bkerler/AutoSatTracker-ESP/doc/HS-785HB Servo_files/637118_quarter_scale_servoblock_on_servo_2_600px.jpg

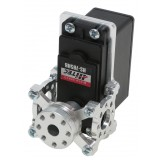
doc/HS-785HB Servo_files/637118_quarter_scale_servoblock_on_servo_2_600px.jpg
