bkerler/AutoSatTracker-ESP/doc/hs-785hb.pdf

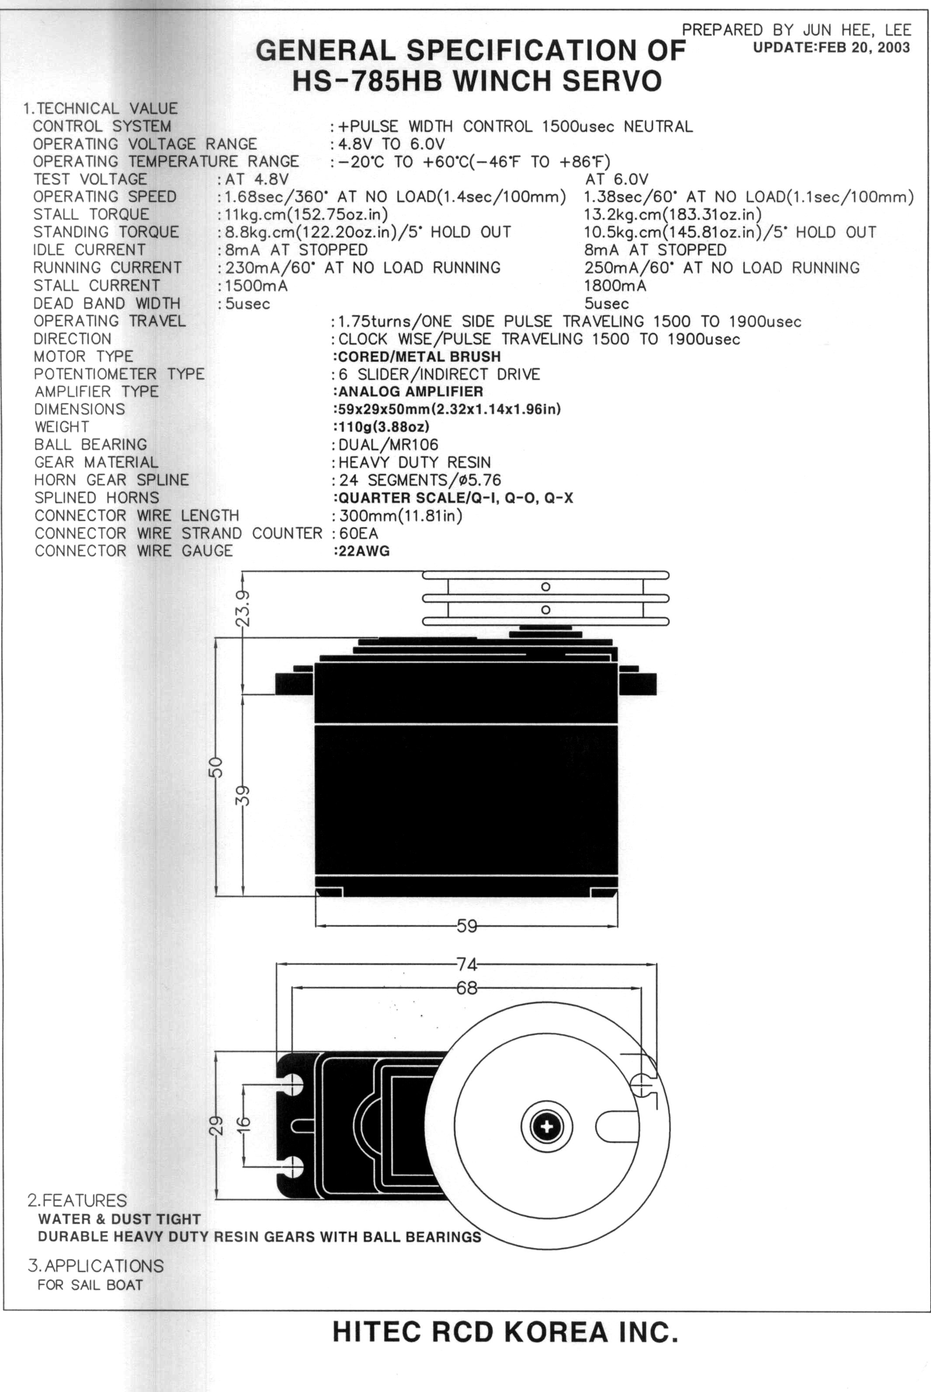
[picture p3: page 1]
