bkerler/AutoSatTracker-ESP/doc/AST-ESP.png

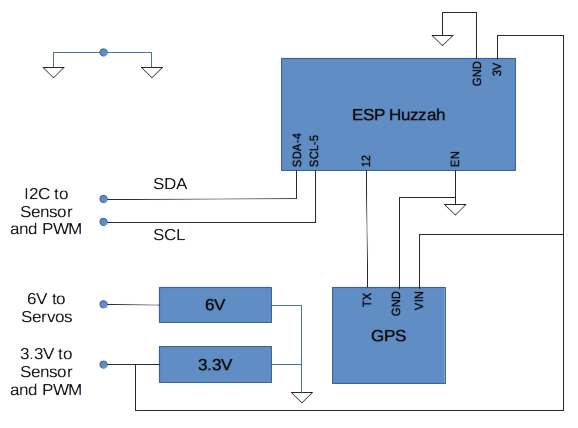
doc/AST-ESP.png
