bkerler/AutoSatTracker-ESP/doc/D645MW Servo_files/32p-hitech-metal-gear-thumbnail.jpg

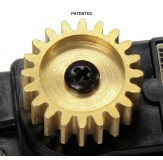
doc/D645MW Servo_files/32p-hitech-metal-gear-thumbnail.jpg
