bkerler/AutoSatTracker-ESP/doc/D645MW Servo_files/32p_futaba_servo_gear_2x2.jpg

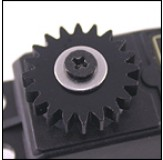
doc/D645MW Servo_files/32p_futaba_servo_gear_2x2.jpg
