bkerler/AutoSatTracker-ESP/doc/D645MW Servo_files/48_pitch_servo_gear_futaba_2x2.jpg

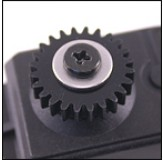
doc/D645MW Servo_files/48_pitch_servo_gear_futaba_2x2.jpg
