bkerler/AutoSatTracker-ESP/doc/D645MW Servo_files/48p_futaba_metal_gear_1.jpg

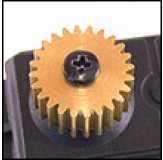
doc/D645MW Servo_files/48p_futaba_metal_gear_1.jpg
