bkerler/AutoSatTracker-ESP/doc/D645MW Servo_files/1804-0032-0001.jpg

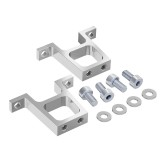
doc/D645MW Servo_files/1804-0032-0001.jpg
