bkerler/AutoSatTracker-ESP/doc/D645MW Servo_files/36645_d645mw_servo_main_600px.jpg

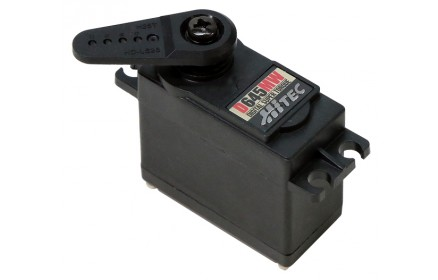
doc/D645MW Servo_files/36645_d645mw_servo_main_600px.jpg
