bkerler/AutoSatTracker-ESP/doc/D645MW Servo_files/44429-dpc-11_dongle-for-pc-programmer-dongle-angle-2-600px.jpg

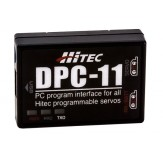
doc/D645MW Servo_files/44429-dpc-11_dongle-for-pc-programmer-dongle-angle-2-600px.jpg
