bkerler/AutoSatTracker-ESP/doc/D645MW Servo_files/55397-1500px.jpg

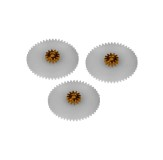
doc/D645MW Servo_files/55397-1500px.jpg
