bkerler/AutoSatTracker-ESP/doc/D645MW Servo_files/55402_hs-625_645_5625_5645_5685_servo_case_set_600px.jpg

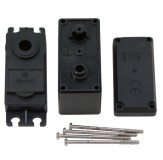
doc/D645MW Servo_files/55402_hs-625_645_5625_5645_5685_servo_case_set_600px.jpg
