bkerler/AutoSatTracker-ESP/doc/D645MW Servo_files/91290a113-1500px.jpg

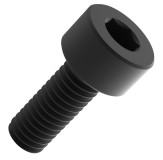
doc/D645MW Servo_files/91290a113-1500px.jpg
