bkerler/AutoSatTracker-ESP/doc/D645MW Servo_files/525124.jpg

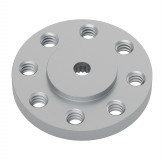
doc/D645MW Servo_files/525124.jpg
