bkerler/AutoSatTracker-ESP/doc/D645MW Servo_files/525130.jpg

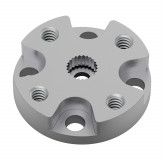
doc/D645MW Servo_files/525130.jpg
