bkerler/AutoSatTracker-ESP/doc/D645MW Servo_files/525136-on-488hb-patented.jpg

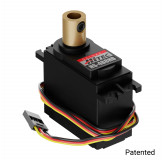
doc/D645MW Servo_files/525136-on-488hb-patented.jpg
