bkerler/AutoSatTracker-ESP/doc/D645MW Servo_files/525142_patented.jpg

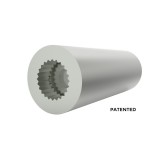
doc/D645MW Servo_files/525142_patented.jpg
