bkerler/AutoSatTracker-ESP/doc/D645MW Servo_files/525144_0280_inch_servo_shaft_spline_end_600px_1_1.jpg

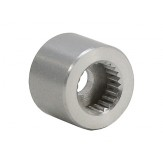
doc/D645MW Servo_files/525144_0280_inch_servo_shaft_spline_end_600px_1_1.jpg
