bkerler/AutoSatTracker-ESP/doc/D645MW Servo_files/575112.jpg

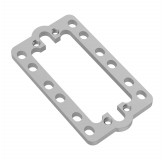
doc/D645MW Servo_files/575112.jpg
