bkerler/AutoSatTracker-ESP/doc/D645MW Servo_files/575124.jpg

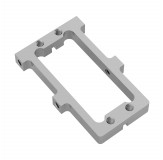
doc/D645MW Servo_files/575124.jpg
