bkerler/AutoSatTracker-ESP/doc/D645MW Servo_files/575144.jpg

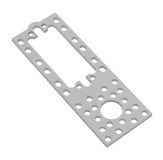
doc/D645MW Servo_files/575144.jpg
