bkerler/AutoSatTracker-ESP/doc/D645MW Servo_files/575148_2.jpg

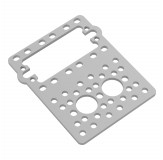
doc/D645MW Servo_files/575148_2.jpg
