bkerler/AutoSatTracker-ESP/doc/D645MW Servo_files/637094_horizontal_gripper_kit_a_main__1.jpg

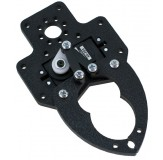
doc/D645MW Servo_files/637094_horizontal_gripper_kit_a_main__1.jpg
