bkerler/AutoSatTracker-ESP/doc/D645MW Servo_files/637096_perpendicular_gripper_kit_b_main_1.jpg

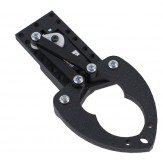
doc/D645MW Servo_files/637096_perpendicular_gripper_kit_b_main_1.jpg
