bkerler/AutoSatTracker-ESP/doc/D645MW Servo_files/637112_standard_futaba_hub_shaft_servoblock_on_servo_2_600px.jpg

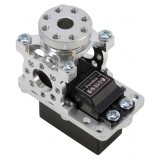
doc/D645MW Servo_files/637112_standard_futaba_hub_shaft_servoblock_on_servo_2_600px.jpg
