bkerler/AutoSatTracker-ESP/doc/D645MW Servo_files/637116_futaba_hitec_servoblock_top_600px.jpg

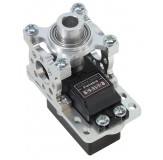
doc/D645MW Servo_files/637116_futaba_hitec_servoblock_top_600px.jpg
