bkerler/AutoSatTracker-ESP/doc/D645MW Servo_files/ddp125_top.jpg

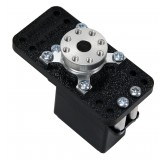
doc/D645MW Servo_files/ddp125_top.jpg
