bkerler/AutoSatTracker-ESP/doc/D645MW Servo_files/ddp155_main.jpg

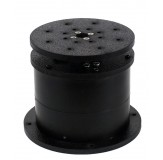
doc/D645MW Servo_files/ddp155_main.jpg
