bkerler/AutoSatTracker-ESP/doc/D645MW Servo_files/ddt500_main.jpg

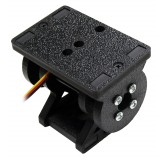
doc/D645MW Servo_files/ddt500_main.jpg
