bkerler/AutoSatTracker-ESP/doc/D645MW Servo_files/ddt540_tilt_system_10_.jpg

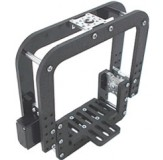
doc/D645MW Servo_files/ddt540_tilt_system_10_.jpg
