bkerler/AutoSatTracker-ESP/doc/D645MW Servo_files/ddt560_tilt_12__1.jpg

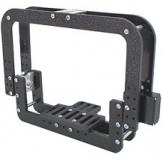
doc/D645MW Servo_files/ddt560_tilt_12__1.jpg
