bkerler/AutoSatTracker-ESP/doc/D645MW Servo_files/hfp-30-digital-servo-programmer-programmer-angled-600px.jpg

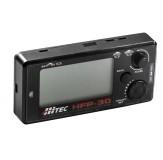
doc/D645MW Servo_files/hfp-30-digital-servo-programmer-programmer-angled-600px.jpg
