bkerler/AutoSatTracker-ESP/doc/D645MW Servo_files/hqdefault_004.jpg

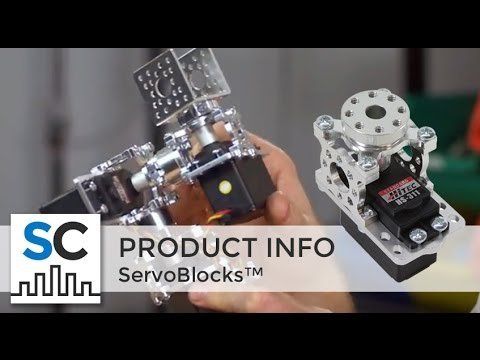
doc/D645MW Servo_files/hqdefault_004.jpg
