bkerler/AutoSatTracker-ESP/doc/D645MW Servo_files/hqdefault_005.jpg

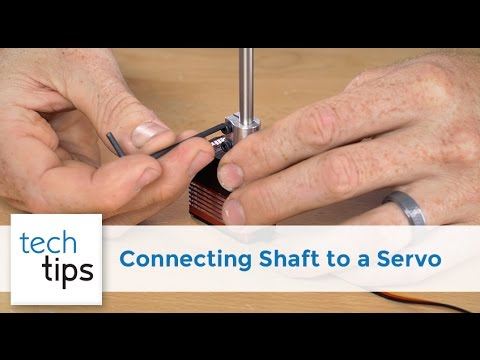
doc/D645MW Servo_files/hqdefault_005.jpg
