bkerler/AutoSatTracker-ESP/doc/D645MW Servo_files/hs25010a-600px.jpg

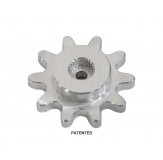
doc/D645MW Servo_files/hs25010a-600px.jpg
