bkerler/AutoSatTracker-ESP/doc/D645MW Servo_files/pn-55395-2-3000px.jpg

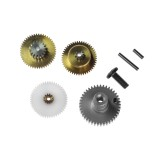
doc/D645MW Servo_files/pn-55395-2-3000px.jpg
