bkerler/AutoSatTracker-ESP/doc/D645MW Servo_files/shaft_1.jpg

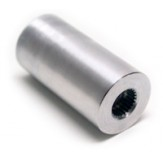
doc/D645MW Servo_files/shaft_1.jpg
