bkerler/AutoSatTracker-ESP/doc/D645MW Servo_files/sprocket-group-pic-1-600px.jpg

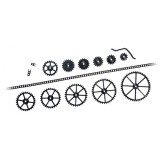
doc/D645MW Servo_files/sprocket-group-pic-1-600px.jpg
