bkerler/AutoSatTracker-ESP/doc/D645MW Servo_files/spt200_main.jpg

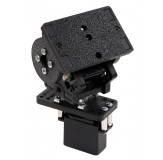
doc/D645MW Servo_files/spt200_main.jpg
