bkerler/AutoSatTracker-ESP/doc/D645MW Servo_files/spt_100_spt100h_main.jpg

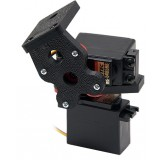
doc/D645MW Servo_files/spt_100_spt100h_main.jpg
