bkerler/AutoSatTracker-ESP/doc/D645MW Servo_files/sr500-servo-rotary-driver-white-bkg-main-600px.jpg

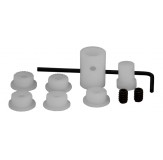
doc/D645MW Servo_files/sr500-servo-rotary-driver-white-bkg-main-600px.jpg
