bkerler/AutoSatTracker-ESP/doc/Downey-AST-Top photo.jpg

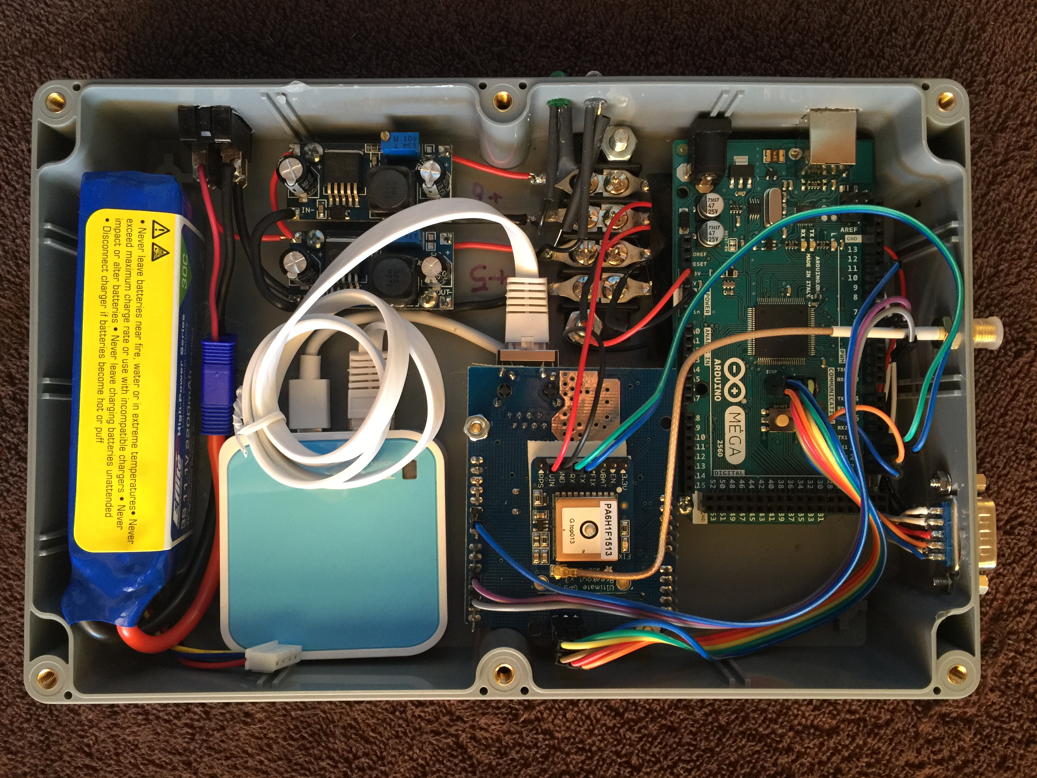
doc/Downey-AST-Top photo.jpg
