bkerler/AutoSatTracker-ESP/doc/HS-785HB Servo_files/48p_hitec_metal_gear_1.jpg

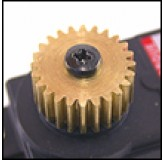
doc/HS-785HB Servo_files/48p_hitec_metal_gear_1.jpg
