bkerler/AutoSatTracker-ESP/doc/HS-785HB Servo_files/55012_hs-785hb_servo_gear_set_1500px.jpg

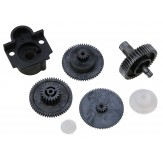
doc/HS-785HB Servo_files/55012_hs-785hb_servo_gear_set_1500px.jpg
