bkerler/AutoSatTracker-ESP/doc/HS-785HB Servo_files/56314_Schematic.jpg

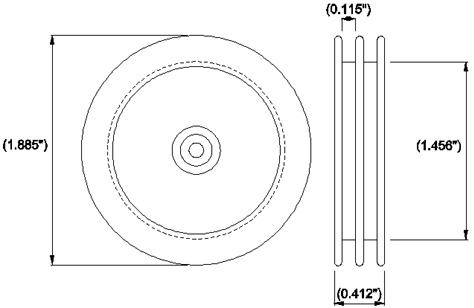
doc/HS-785HB Servo_files/56314_Schematic.jpg
