bkerler/AutoSatTracker-ESP/doc/HS-785HB Servo_files/525116-single-servo-arm-corner-to-corner-top-600px.jpg

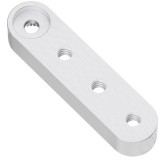
doc/HS-785HB Servo_files/525116-single-servo-arm-corner-to-corner-top-600px.jpg
