bkerler/AutoSatTracker-ESP/doc/HS-785HB Servo_files/525118-dual-servo-arm-corner-to-corner-top-600px.jpg

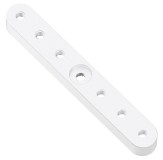
doc/HS-785HB Servo_files/525118-dual-servo-arm-corner-to-corner-top-600px.jpg
