bkerler/AutoSatTracker-ESP/doc/HS-785HB Servo_files/575116.jpg

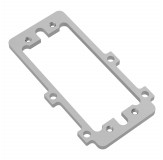
doc/HS-785HB Servo_files/575116.jpg
