bkerler/AutoSatTracker-ESP/doc/HS-785HB Servo_files/637120_quarter_scale_servoblock_on_servo_with_shaft_600px.jpg

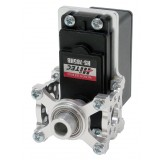
doc/HS-785HB Servo_files/637120_quarter_scale_servoblock_on_servo_with_shaft_600px.jpg
