bkerler/AutoSatTracker-ESP/doc/HS-785HB Servo_files/637169_785_gear_rack_single_sideways_kit_main_600px.jpg

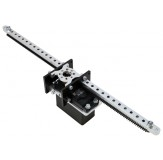
doc/HS-785HB Servo_files/637169_785_gear_rack_single_sideways_kit_main_600px.jpg
