bkerler/AutoSatTracker-ESP/doc/HS-785HB Servo_files/637170_785_gear_rack_kit_angle_600px.jpg

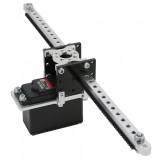
doc/HS-785HB Servo_files/637170_785_gear_rack_kit_angle_600px.jpg
