bkerler/AutoSatTracker-ESP/doc/HS-785HB Servo_files/637171_785_gear_rack_standard_dual_kit_main_600px.jpg

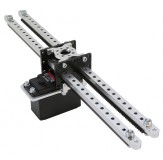
doc/HS-785HB Servo_files/637171_785_gear_rack_standard_dual_kit_main_600px.jpg
