bkerler/AutoSatTracker-ESP/doc/HS-785HB Servo_files/637190_785_gear_rack_sideways_dual_kit_main_600px.jpg

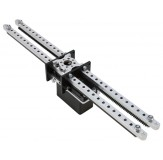
doc/HS-785HB Servo_files/637190_785_gear_rack_sideways_dual_kit_main_600px.jpg
