bkerler/AutoSatTracker-ESP/doc/HS-785HB Servo_files/15435564483DC63035-E2B1-4D74-B549-9035334CB773.jpeg

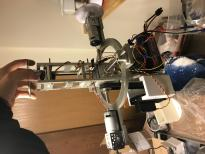
doc/HS-785HB Servo_files/15435564483DC63035-E2B1-4D74-B549-9035334CB773.jpeg
