bkerler/AutoSatTracker-ESP/doc/HS-785HB Servo_files/hs785_slider_kit_back_600px.jpg

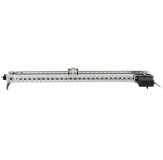
doc/HS-785HB Servo_files/hs785_slider_kit_back_600px.jpg
