bkerler/AutoSatTracker-ESP/doc/HS-785HB Servo_files/hs-785hb_33785s_main.jpg

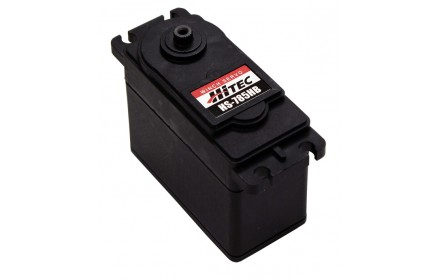
doc/HS-785HB Servo_files/hs-785hb_33785s_main.jpg
