bkerler/AutoSatTracker-ESP/doc/HS-785HB Servo_files/pt-785ss_main_picture.jpg

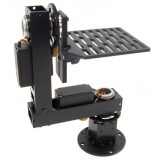
doc/HS-785HB Servo_files/pt-785ss_main_picture.jpg
