bkerler/AutoSatTracker-ESP/doc/HS-785HB Servo_files/rsa32-2hs-12-mounted-on-785hb-cu-3000px.jpg

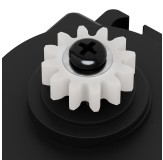
doc/HS-785HB Servo_files/rsa32-2hs-12-mounted-on-785hb-cu-3000px.jpg
