bkerler/AutoSatTracker-ESP/doc/HS-785HB Servo_files/rsa48-2hs-18-mounted-on-785hb-cu-3000px.jpg

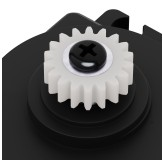
doc/HS-785HB Servo_files/rsa48-2hs-18-mounted-on-785hb-cu-3000px.jpg
