bkerler/AutoSatTracker-ESP/doc/HS-785HB Servo_files/sw1875h_servo_wheel.jpg

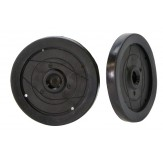
doc/HS-785HB Servo_files/sw1875h_servo_wheel.jpg
