bkerler/AutoSatTracker-ESP/doc/IMG_0182.JPG

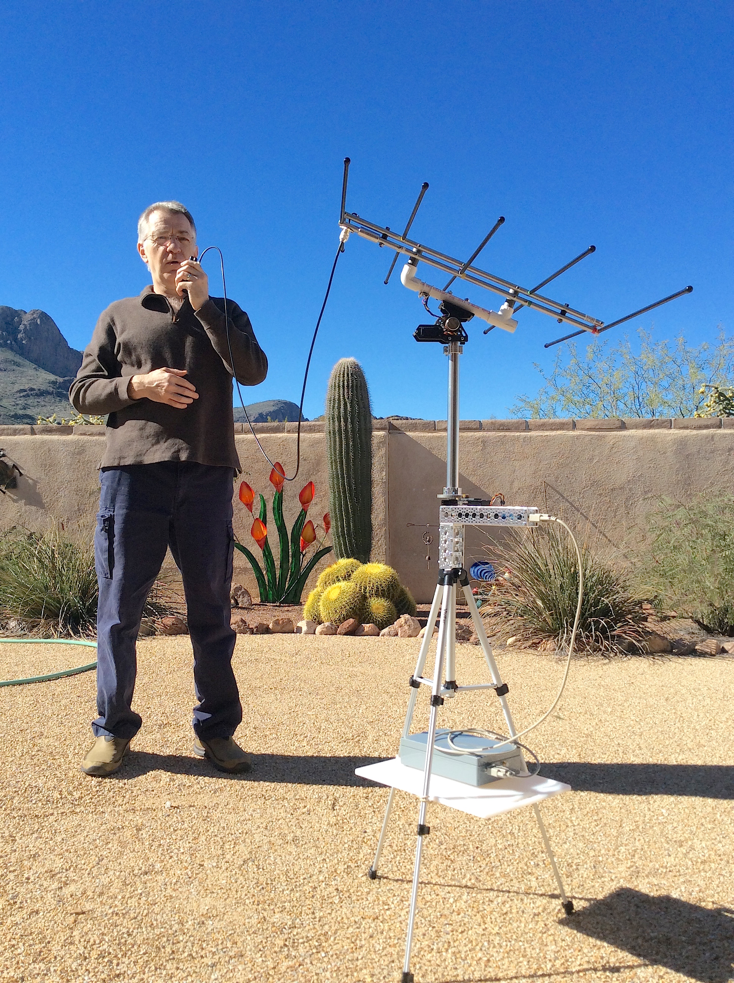
doc/IMG_0182.JPG
