bkerler/AutoSatTracker-ESP/doc/IMG_0186.JPG

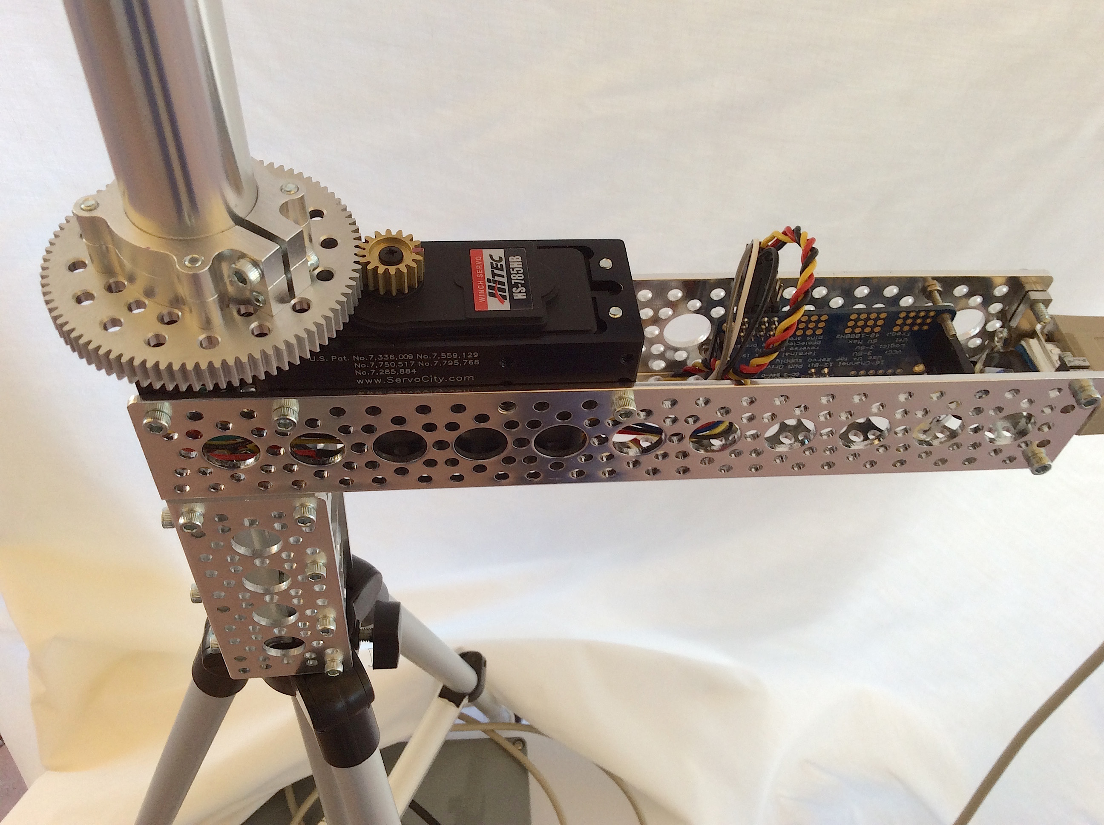
doc/IMG_0186.JPG
