bkerler/AutoSatTracker-ESP/doc/IMG_0195.JPG

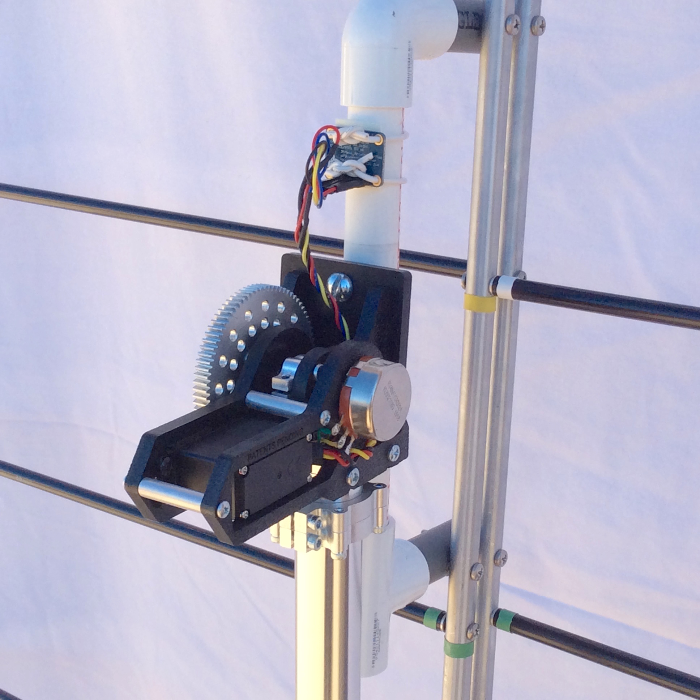
doc/IMG_0195.JPG
