bkerler/AutoSatTracker-ESP/doc/IMG_0196.JPG

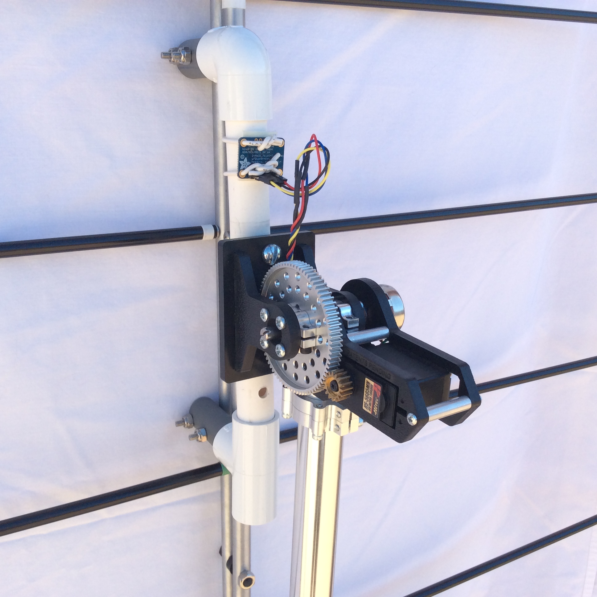
doc/IMG_0196.JPG
