bkerler/AutoSatTracker-ESP/doc/IMG_0198.JPG

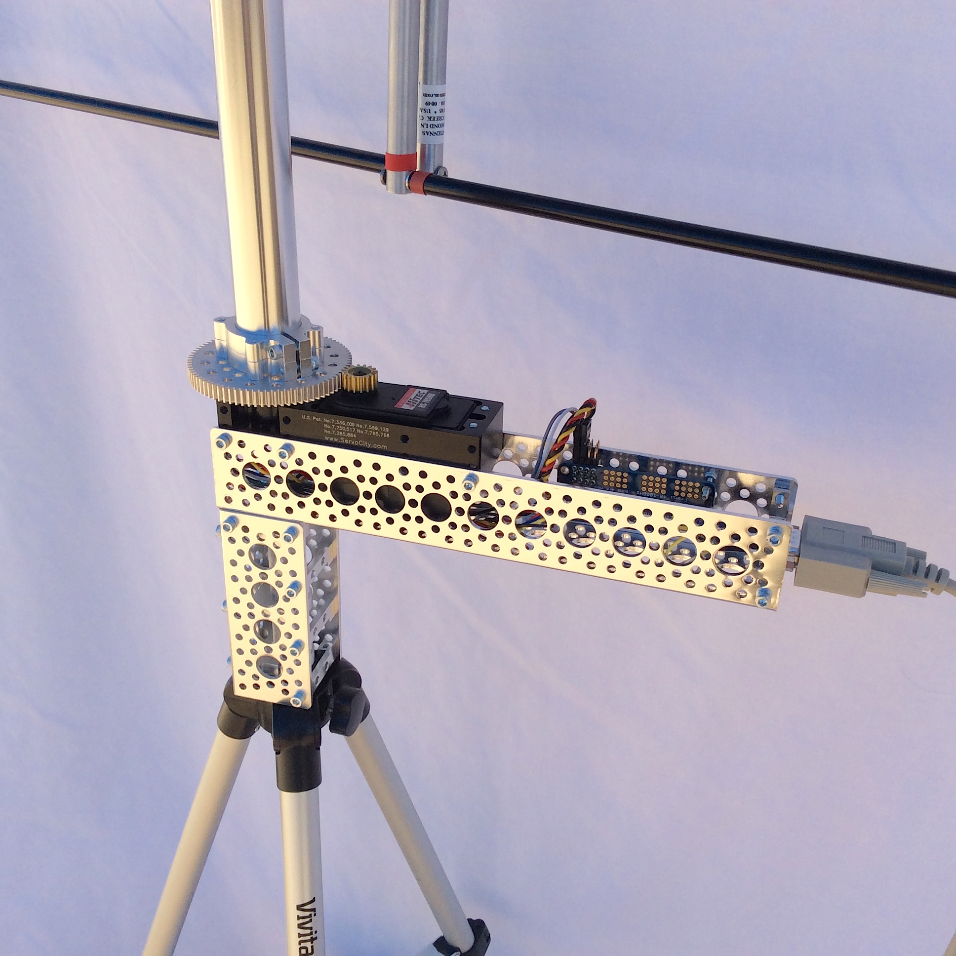
doc/IMG_0198.JPG
