bkerler/AutoSatTracker-ESP/doc/PLAN-13 Satellite Position Calculation Program_files/fig01.gif

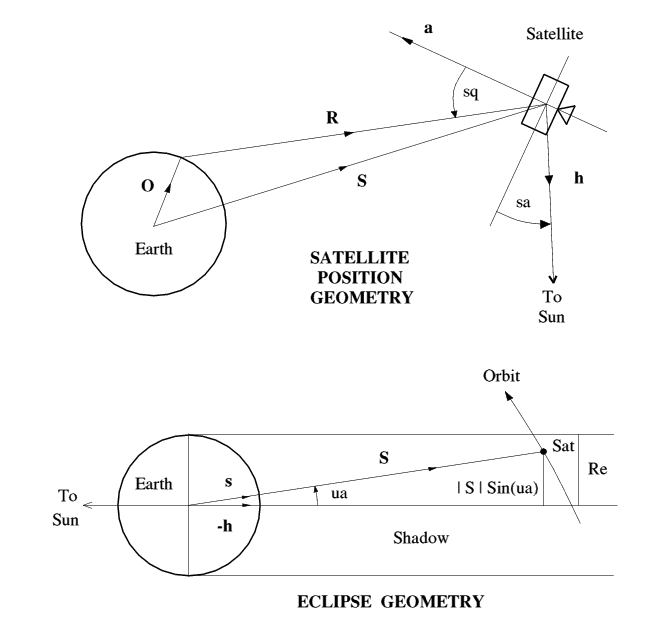
doc/PLAN-13 Satellite Position Calculation Program_files/fig01.gif
