bkerler/AutoSatTracker-ESP/doc/PLAN-13 Satellite Position Calculation Program_files/fig02.gif

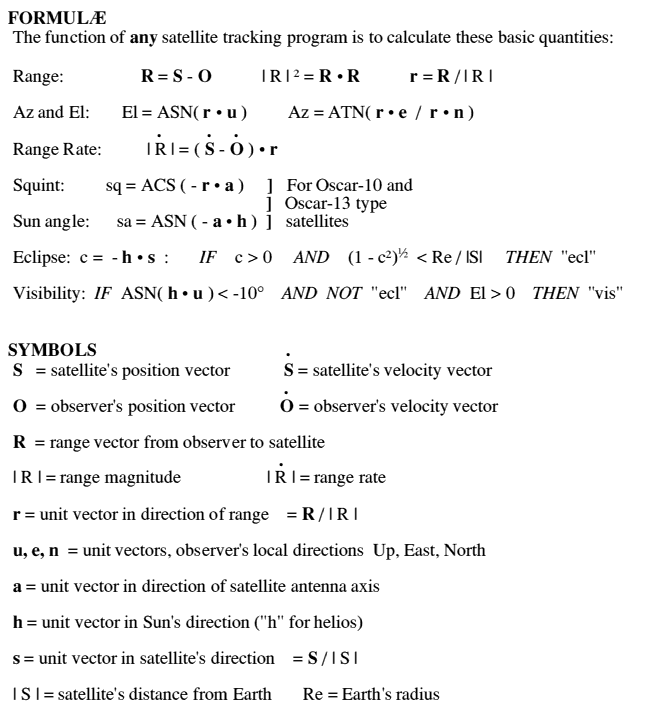
doc/PLAN-13 Satellite Position Calculation Program_files/fig02.gif
