bkerler/AutoSatTracker-ESP/doc/Tripod-closeup.jpg

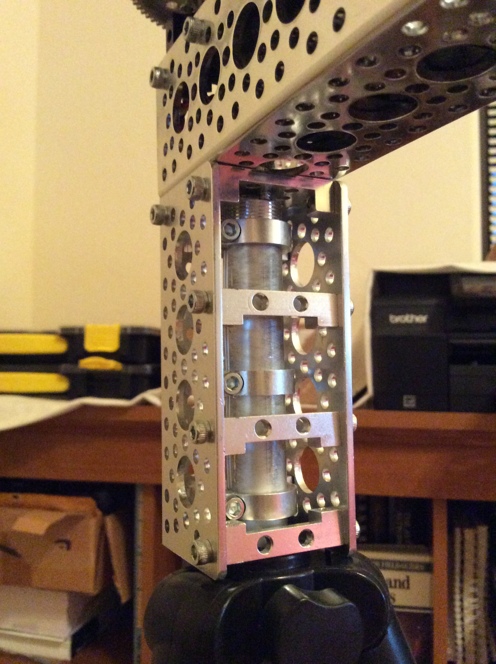
doc/Tripod-closeup.jpg
