bkerler/AutoSatTracker-ESP/doc/Using Arduino IDE | Adafruit Feather HUZZAH ESP8266 | Adafruit Learning System_files/2821-05.jpg

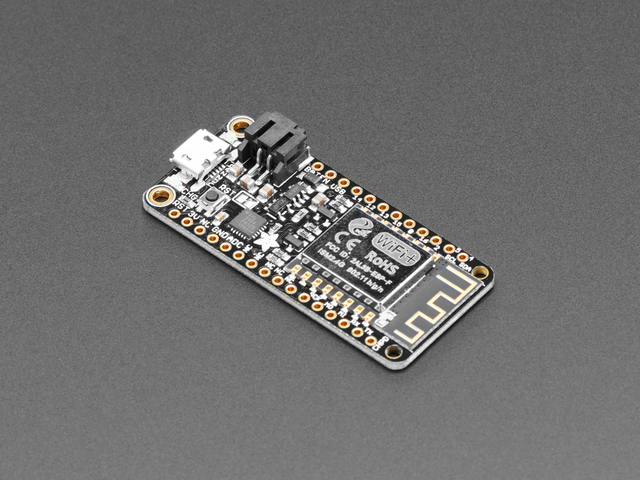
doc/Using Arduino IDE | Adafruit Feather HUZZAH ESP8266 | Adafruit Learning System_files/2821-05.jpg
