bkerler/AutoSatTracker-ESP/doc/D645MW Servo_files/fsa250-assembly-main-1500px.jpg

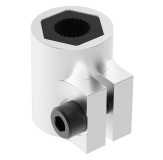
doc/D645MW Servo_files/fsa250-assembly-main-1500px.jpg
