bkerler/AutoSatTracker-ESP/doc/HS-785HB Servo_files/hsa250-assembly-main-1500px.jpg

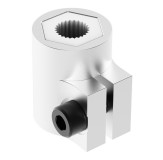
doc/HS-785HB Servo_files/hsa250-assembly-main-1500px.jpg
