bkerler/AutoSatTracker-ESP/(threads)

Thread 3 (2025-06-07):

Constant back and forth movement while tracking.

SamuelHiatt79, 2025-06-07:
On your Github page it says "If the servo moves back and forth on tracking due to measurement errors of the BNO055 sensor, make sure to mod GOOD_ERROR to the error degree (currently 0.8 degree) in Gimbal.h"

There is no GOOD_ERROR in the Gimbal.h script, or any other script in this sketch.

How do you stop the constant back and forth?

bkerler, 2025-06-08:
Actually, GOOD_ERROR is in Gimbal.h, see https://github.com/bkerler/AutoSatTracker-ESP/blob/master/src/Gimbal.h#L26

SamuelHiatt79, 2025-06-12:
I am using your files now. Now I am getting compile errors.
Are you using the Adafruit Feather ESP8266 Huzzah?

SamuelHiatt79, 2025-06-14:
When I complied and uploaded your version. The GPS, Gimbal, and IMU are not detected by the Huzzah.

Any thoughts?
