bkerler/AutoSatTracker-ESP/doc/Downey-AST-Block diagram.pdf

## Autonomous Satellite Tracker

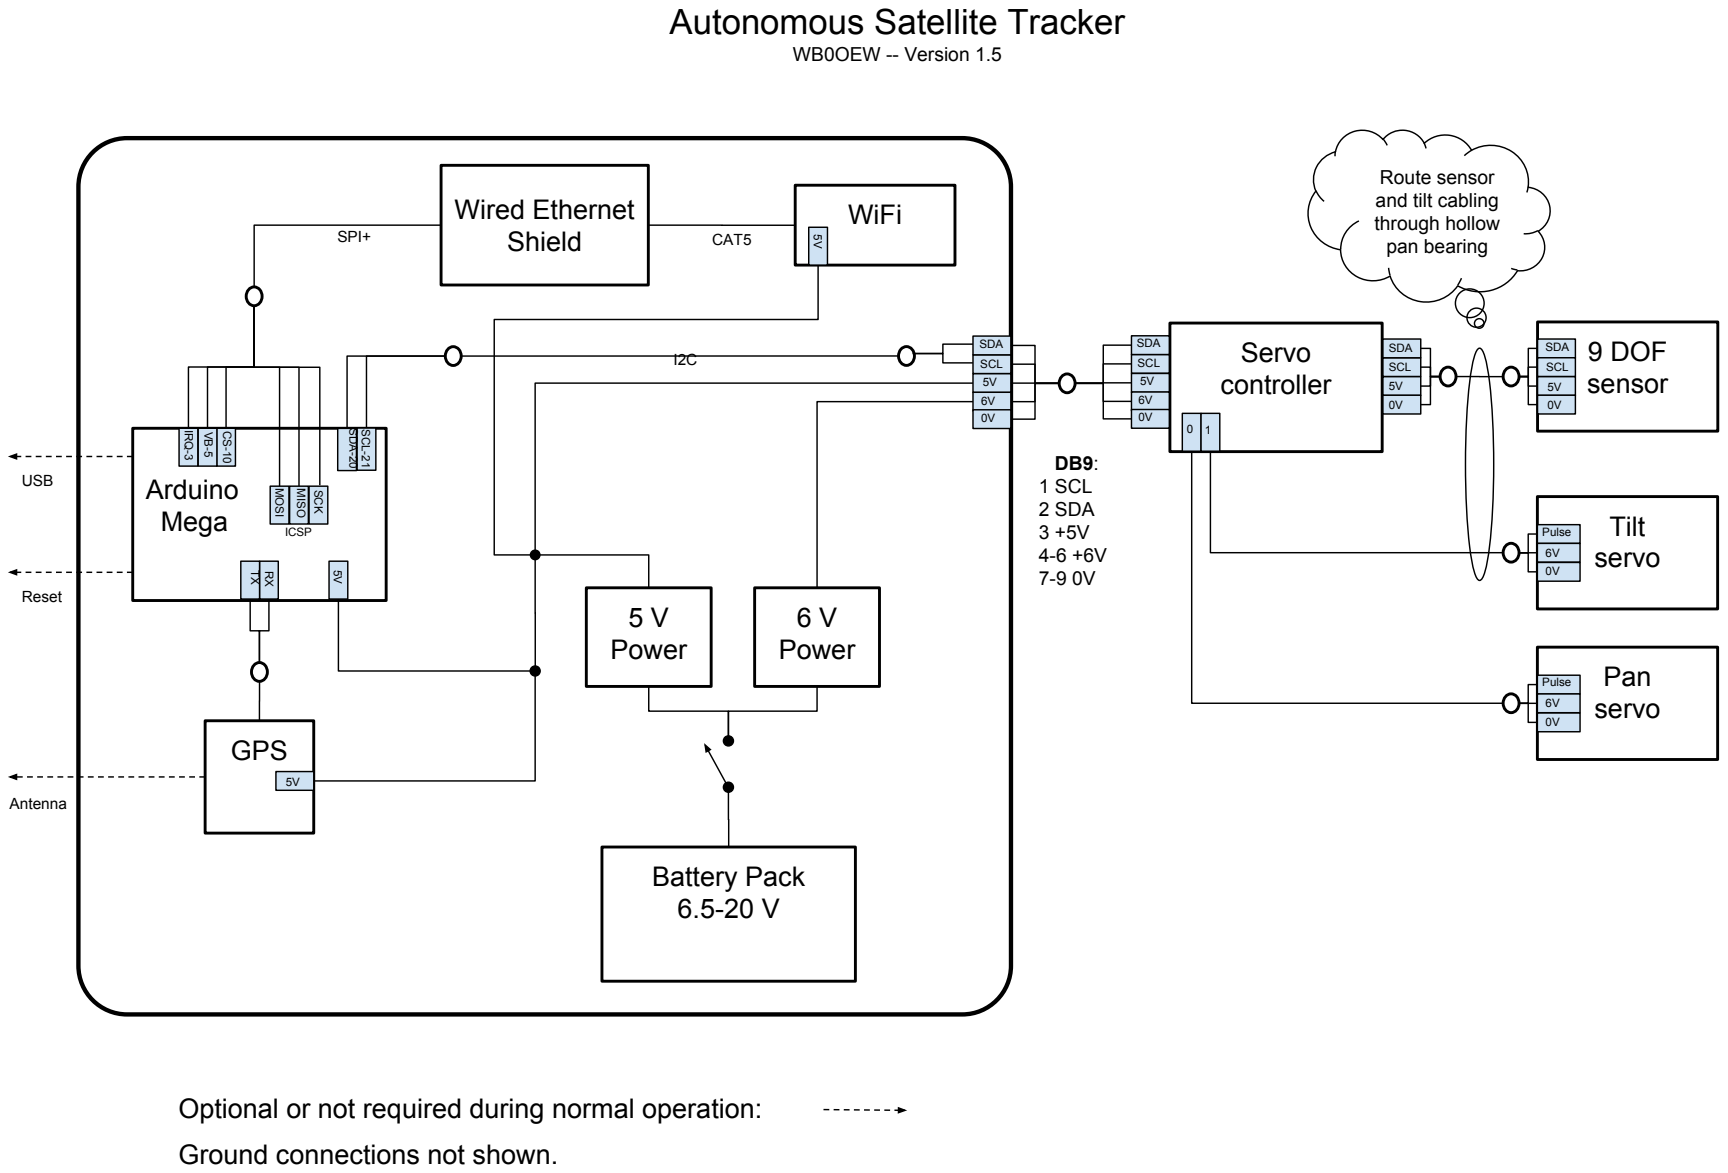
[picture p118: page 1]
Arduino Mega; SDA-20; SCL-21; MISO; IRQ-3; SCK; MOSI; ICSP; Wired Ethernet Shield; WiFi; 6 V Power; Battery Pack 6.5-20 V; WB0OEW -- Version 1.5; Servo controller; CAT5; SPI+; 5 V Power; USB; GPS; Antenna; SDA; SCL; 9 DOF; sensor; Tilt servo ⁶V; Pulse; Pan servo ⁶V; DB9: 1 SCL 2 SDA 3 +5V 4-6 +6V 7-9 0V; Reset

Route sensor
and tilt cabling
through hollow
pan bearing

Optional or not required during normal operation:
Ground connections not shown.
