bkerler/AutoSatTracker-ESP/src/wmm.h

static double epoc = 2025.0;
const double c0[13][13]={
{	0.0,	-29351.8,	-2556.6,	1361.0,	895.0,	-233.2,	64.4,	79.5,	23.2,	4.6,	-1.3,	2.9,	-2.0,	},
{	4545.4,	-1410.8,	2951.1,	-2404.1,	799.5,	368.9,	63.8,	-77.0,	10.8,	7.8,	-6.4,	-1.5,	-0.2,	},
{	-3133.6,	-815.1,	1649.3,	1243.8,	55.7,	187.2,	76.9,	-8.8,	-17.5,	3.0,	0.2,	-2.5,	0.3,	},
{	-56.6,	237.5,	-549.5,	453.6,	-281.1,	-138.7,	-115.7,	59.3,	2.0,	-0.2,	2.0,	2.4,	1.2,	},
{	278.6,	-133.9,	212.0,	-375.6,	12.1,	-142.0,	-40.9,	15.8,	-21.7,	-2.5,	-1.0,	-0.6,	-1.3,	},
{	45.4,	220.2,	-122.9,	43.0,	106.1,	20.9,	14.9,	2.5,	16.9,	-13.1,	-0.6,	-0.1,	0.6,	},
{	-18.4,	16.8,	48.8,	-59.8,	10.9,	72.7,	-60.7,	-11.1,	15.0,	2.4,	-0.9,	-0.6,	0.6,	},
{	-48.9,	-14.4,	-1.0,	23.4,	-7.4,	-25.1,	-2.3,	14.2,	-16.8,	8.6,	1.5,	-0.1,	0.5,	},
{	7.1,	-12.6,	11.4,	-9.7,	12.7,	0.7,	-5.2,	3.9,	0.9,	-8.7,	0.9,	1.1,	-0.1,	},
{	-24.8,	12.2,	8.3,	-3.3,	-5.2,	7.2,	-0.6,	0.8,	10.0,	-12.9,	-2.7,	-1.0,	-0.4,	},
{	3.3,	0.0,	2.4,	5.3,	-9.1,	0.4,	-4.2,	-3.8,	0.9,	-9.1,	-3.9,	-0.2,	-0.2,	},
{	0.0,	2.9,	-0.6,	0.2,	0.5,	-0.3,	-1.2,	-1.7,	-2.9,	-1.8,	-2.3,	2.6,	-1.3,	},
{	-1.3,	0.7,	1.0,	-1.4,	-0.0,	0.6,	-0.1,	0.8,	0.1,	-1.0,	0.1,	0.2,	-0.7,	},
};
const double cd0[13][13]={
{	0.0,	12.0,	-11.6,	-1.3,	-1.6,	0.6,	-0.2,	-0.0,	-0.1,	-0.0,	0.1,	0.0,	0.0,	},
{	-21.5,	9.7,	-5.2,	-4.2,	-2.4,	1.4,	-0.4,	-0.1,	0.2,	-0.1,	0.0,	-0.0,	0.0,	},
{	-27.7,	-12.1,	-8.0,	0.4,	-6.0,	0.0,	0.9,	-0.1,	0.0,	0.1,	0.1,	0.0,	-0.0,	},
{	4.0,	-0.3,	-4.1,	-15.6,	5.6,	0.6,	1.2,	0.5,	0.5,	0.3,	0.1,	0.0,	-0.0,	},
{	-1.1,	4.1,	1.6,	-4.4,	-7.0,	2.2,	-0.9,	-0.1,	-0.1,	-0.3,	-0.0,	0.0,	-0.0,	},
{	-0.5,	2.2,	0.4,	1.7,	1.9,	0.9,	0.3,	-0.8,	0.3,	0.0,	-0.3,	-0.1,	-0.0,	},
{	0.3,	-1.6,	-0.4,	0.9,	0.7,	0.9,	0.9,	-0.8,	0.2,	0.3,	0.0,	0.0,	0.1,	},
{	0.6,	0.5,	-0.8,	0.0,	-1.0,	0.6,	-0.2,	0.8,	-0.0,	-0.1,	-0.1,	-0.0,	-0.0,	},
{	-0.2,	0.5,	-0.4,	0.4,	-0.5,	-0.6,	0.3,	0.2,	0.2,	0.1,	-0.1,	-0.1,	0.0,	},
{	-0.3,	0.3,	-0.3,	0.3,	0.2,	-0.1,	-0.2,	0.4,	0.1,	-0.1,	-0.0,	-0.1,	0.0,	},
{	0.0,	-0.0,	-0.2,	0.1,	-0.1,	0.1,	0.0,	-0.1,	0.2,	-0.0,	-0.0,	-0.1,	-0.1,	},
{	-0.0,	0.1,	-0.0,	0.1,	-0.0,	-0.0,	0.1,	-0.0,	0.0,	0.0,	0.0,	-0.1,	-0.0,	},
{	-0.0,	0.0,	-0.1,	0.1,	-0.0,	-0.0,	-0.0,	0.0,	-0.0,	-0.0,	0.0,	-0.1,	-0.1,	},
};
